siddharthspathran-oss/athena-desk-orb/stl/orb_bme280_pod.stl

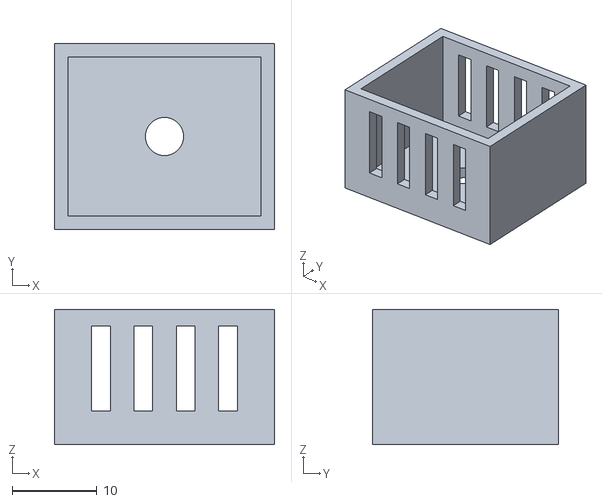
[picture p2: CAD file, 2026-10-14]
stl/orb_bme280_pod.stl
26.0 x 22.0 x 16.0
