siddharthspathran-oss/athena-desk-orb/stl/orb_top_plate.stl

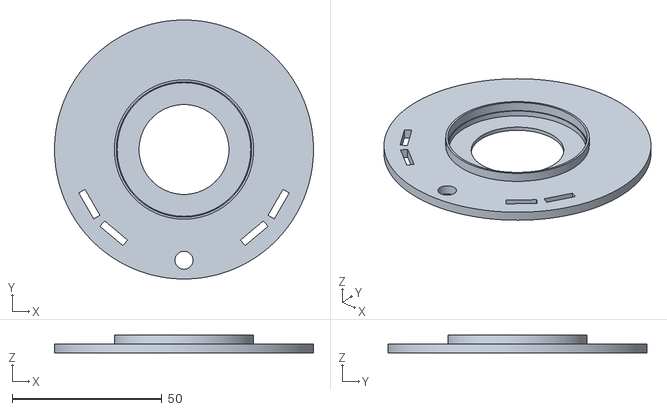
[picture p3: CAD file, 2026-10-14]
stl/orb_top_plate.stl
86.5 x 86.5 x 6.00
