siddharthspathran-oss/athena-desk-orb/stl/orb_mid_deck.stl

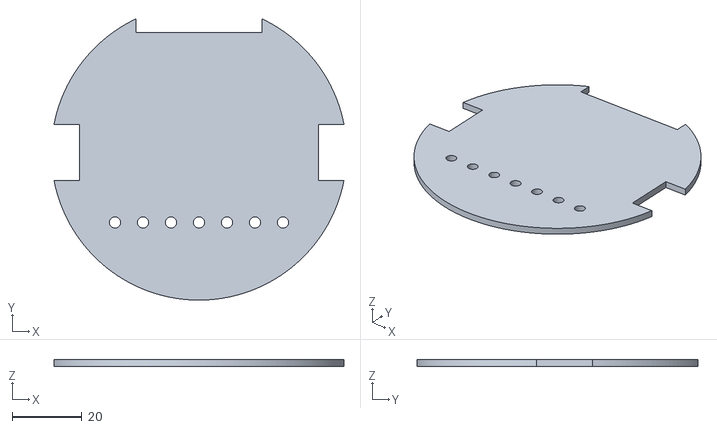
[picture p4: CAD file, 2026-10-14]
stl/orb_mid_deck.stl
82.9 x 80.4 x 2.00
