siddharthspathran-oss/athena-desk-orb/stl/orb_base.stl

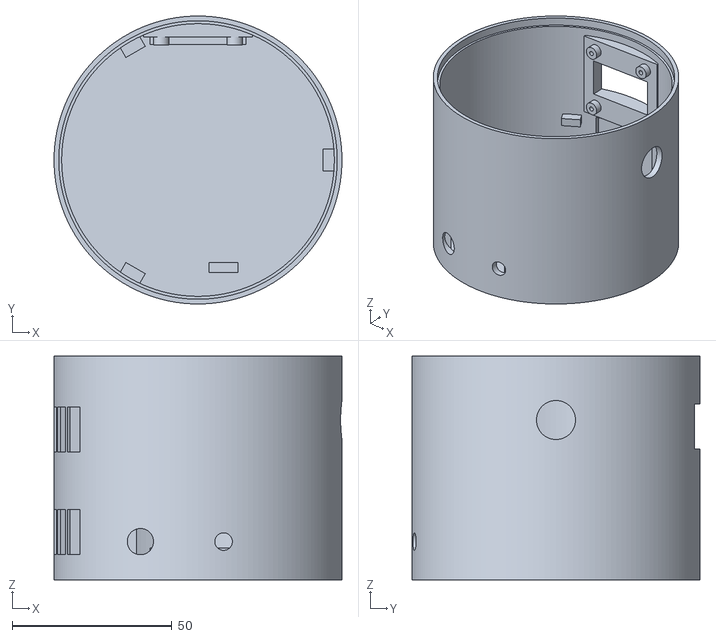
[picture p5: CAD file, 2026-10-14]
stl/orb_base.stl
90.0 x 90.0 x 70.0
